Harnesser/DCC-Controller/(commit log)

2010-09-18 blinking the LED using interrupts
2010-10-02 Reset the counter when the interrupt triggers else timer2 will run until overflow, and changing the compare register won't have any effect on the frequency of the output.
2010-10-02 Set timer2 for DCC's 58us cycle period.
2010-10-02 Starting to put together a DCC frame
2010-10-03 Refactored frame builder.
2010-10-03 Better frame building refactoring.
2010-10-03 Playing with a trigger to point out start of frame. Seems to be resetting every now and again, and seems to be coming out backwards. Not sure if it's PK2-LA or my code. Not sure how much to trust PK2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
2010-11-14 Added a status bar and prevent window resizing.
    [dcc_control_panel.py]
2011-01-15 Finished first cut version of blog post #1 - the overview.
2013-02-16 Update Arduino firmware file extension to .ino
